rtreichl/RGB_Led_Controller/(list of files, drawings)

Other design files:
eagle/LED Sockel.pcb
