rtreichl/RGB_Led_Controller/eagle/LED Sockel.brd

## EAGLE design eagle/LED Sockel.brd (2016-02-29)

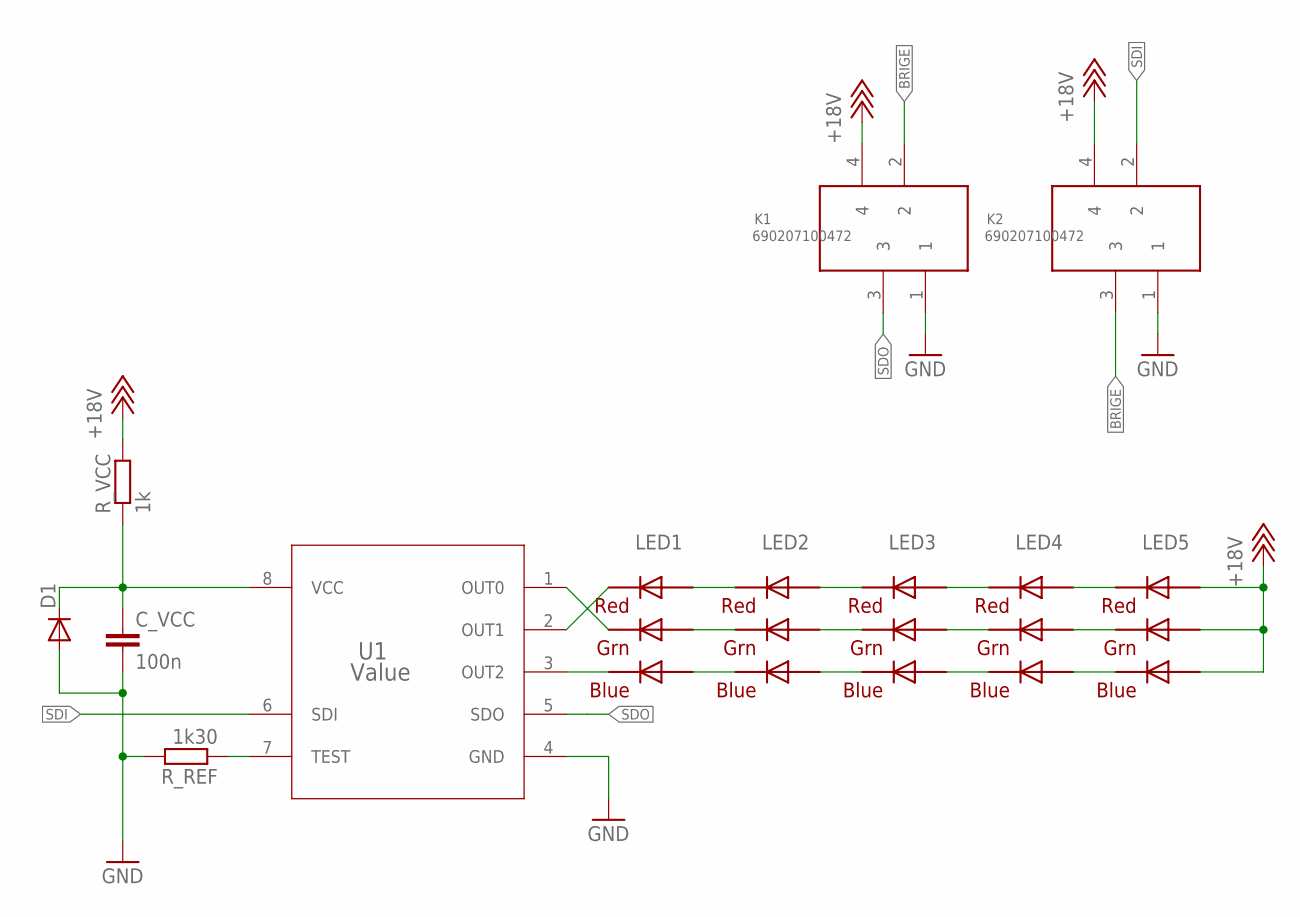
[picture p1: schematic LED Sockel.sch, LED]

Parts:
C_VCC: 100n; C0603
D1: DIODE-SOD523; SOD523
K1, K2: 690207100472
LED1, LED2, LED3, LED4, LED5: RGBLED5050
R_REF: 1k30; R0603
R_VCC: 1k; R0805
U1: Value; D0008A_N

Connections:
+18V: K1.4, K2.4, LED5.1 (GREEN_A), LED5.2 (RED_A), LED5.3 (BLUE_A), R_VCC.2
BRIGE: K1.2, K2.3
GND: C_VCC.2, D1.A, K1.1, K2.1, R_REF.2, U1.4 (GND)
unnamed: LED4.1 (GREEN_A), LED5.6 (GREEN_C)
unnamed: LED4.3 (BLUE_A), LED5.4 (BLUE_C)
unnamed: LED4.2 (RED_A), LED5.5 (RED_C)
unnamed: LED3.1 (GREEN_A), LED4.6 (GREEN_C)
unnamed: LED3.3 (BLUE_A), LED4.4 (BLUE_C)
unnamed: LED3.2 (RED_A), LED4.5 (RED_C)
unnamed: LED2.1 (GREEN_A), LED3.6 (GREEN_C)
unnamed: LED2.3 (BLUE_A), LED3.4 (BLUE_C)
unnamed: LED2.2 (RED_A), LED3.5 (RED_C)
unnamed: LED1.1 (GREEN_A), LED2.6 (GREEN_C)
unnamed: LED1.3 (BLUE_A), LED2.4 (BLUE_C)
unnamed: LED1.2 (RED_A), LED2.5 (RED_C)
unnamed: LED1.4 (BLUE_C), U1.3 (OUT2)
unnamed: LED1.6 (GREEN_C), U1.1 (OUT0)
unnamed: LED1.5 (RED_C), U1.2 (OUT1)
unnamed: C_VCC.1, D1.C, R_VCC.1, U1.8 (VCC)
unnamed: R_REF.1, U1.7 (TEST)
SDI: K2.2, U1.6 (SDI)
SDO: K1.3, U1.5 (SDO)

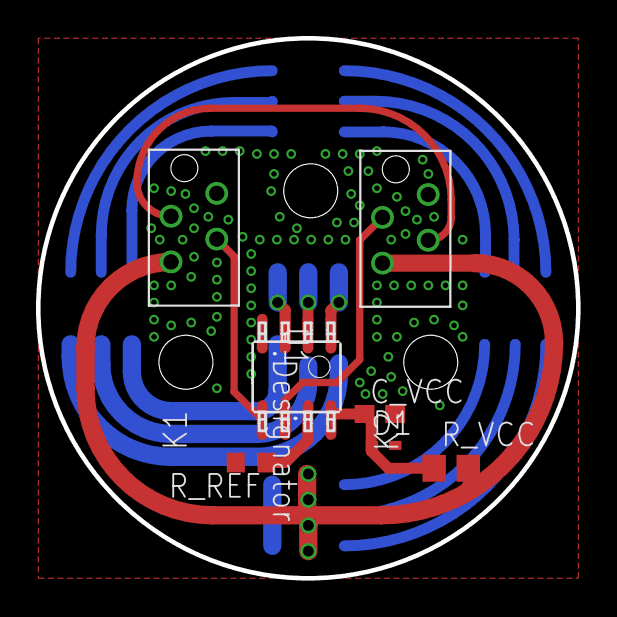
[picture p2: board LED Sockel.brd from above]

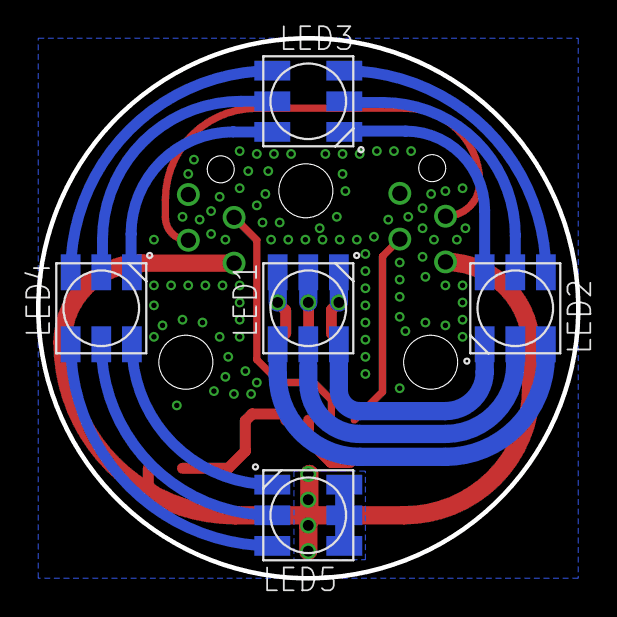
[picture p3: board LED Sockel.brd from below]

Board: 2 copper layers, 30.0 x 30.0 mm, 12 parts (5 on the bottom side), 22 nets.
