rtreichl/RGB_Led_Controller/eagle/LED Controller.brd

## EAGLE design eagle/LED Controller.brd (2016-02-29)

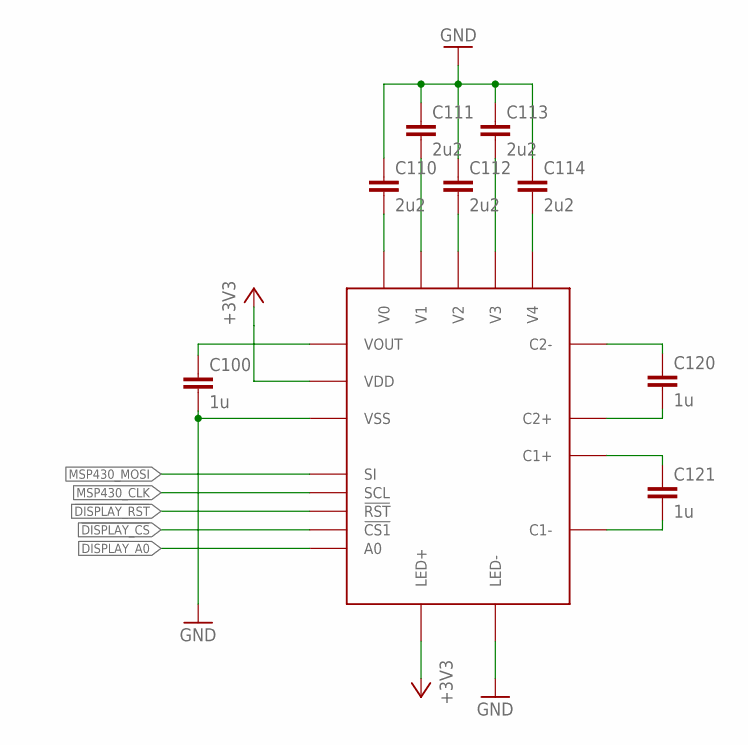
[picture p4: schematic LED Controller.sch, sheet 1, Display]

Parts:
C100, C120, C121: 1u; C0603
C110, C111, C112, C113, C114: 2u2; C0603
U$3: DISPLAY; NHD-C12832A1Z-NSW-BBW-3V3

Connections:
!DISPLAY_CS: U$3.P17 (!CS1); also elsewhere on the board
!DISPLAY_RST: U$3.P16 (!RST); also elsewhere on the board
+3V3: U$3.A (LED+), U$3.P12 (VDD); also elsewhere on the board
DISPLAY_A0: U$3.P15 (A0); also elsewhere on the board
GND: C100.2, C110.1, C111.1, C112.1, C113.1, C114.1, U$3.K (LED-), U$3.P11 (VSS); also elsewhere on the board
MSP430_CLK: U$3.P14 (SCL); also elsewhere on the board
MSP430_MOSI: U$3.P13 (SI); also elsewhere on the board
unnamed: C110.2, U$3.P1 (V0)
unnamed: C111.2, U$3.P2 (V1)
unnamed: C112.2, U$3.P3 (V2)
unnamed: C113.2, U$3.P4 (V3)
unnamed: C114.2, U$3.P5 (V4)
unnamed: C120.2, U$3.P7 (C2+)
unnamed: C120.1, U$3.P6 (C2-)
unnamed: C121.1, U$3.P8 (C1+)
unnamed: C121.2, U$3.P9 (C1-)
unnamed: C100.1, U$3.P10 (VOUT)

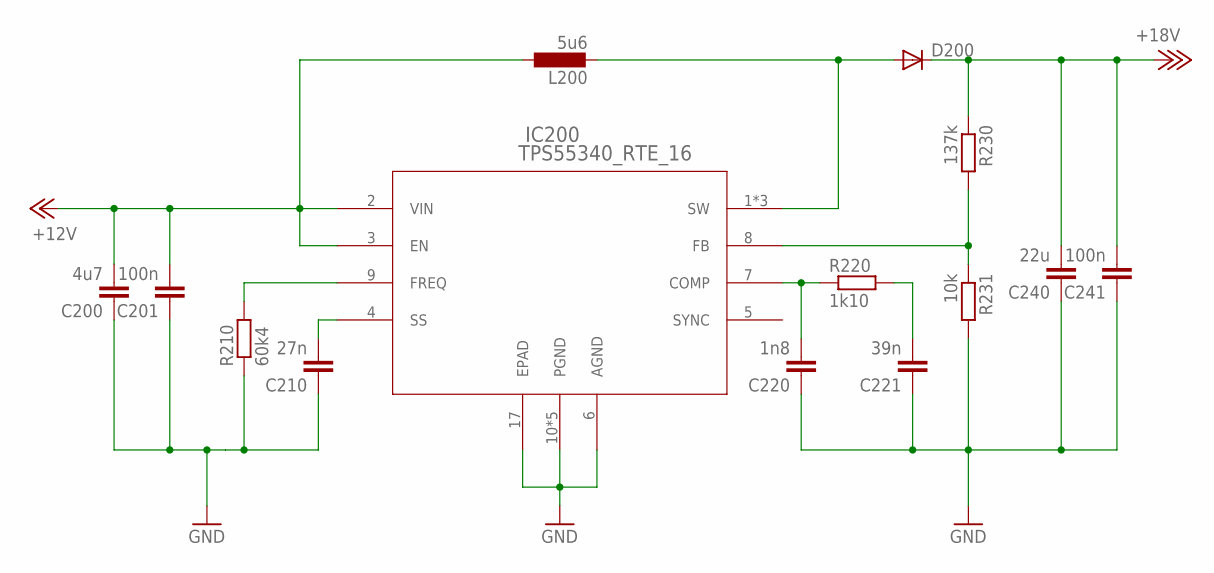
[picture p5: schematic LED Controller.sch, sheet 2, Boosted Converter]

Parts:
C200: 4u7; C1206
C201, C241: 100n; C1206
C210: 27n; C0603
C220: 1n8; C0603
C221: 39n; C0603
C240: 22u; C1210
D200: DIODE-SMC; SMC
IC200: TPS55340_RTE_16; RTE16
L200: 5u6; SRP5030T
R210: 60k4; R0603
R220: 1k10; R0603
R230: 137k; R0603
R231: 10k; R0603

Connections:
+12V: C200.2, C201.2, IC200.2 (VIN), IC200.3 (EN), L200.V_1 (1); also elsewhere on the board
+18V: C240.2, C241.2, D200.C, R230.1; also elsewhere on the board
GND: C200.1, C201.1, C210.1, C220.1, C221.1, C240.1, C241.1, IC200.6 (AGND), IC200.10 (PGND), IC200.11 (PGND), IC200.12 (PGND), IC200.13 (PGND), IC200.14 (PGND), IC200.17 (EPAD), R210.1, R231.2; also elsewhere on the board
unnamed: C220.2, IC200.7 (COMP), R220.1
unnamed: D200.A, IC200.1 (SW), IC200.15 (SW), IC200.16 (SW), L200.V_2 (2)
unnamed: IC200.8 (FB), R230.2, R231.1
unnamed: IC200.9 (FREQ), R210.2
unnamed: C210.2, IC200.4 (SS)
unnamed: C221.2, R220.2

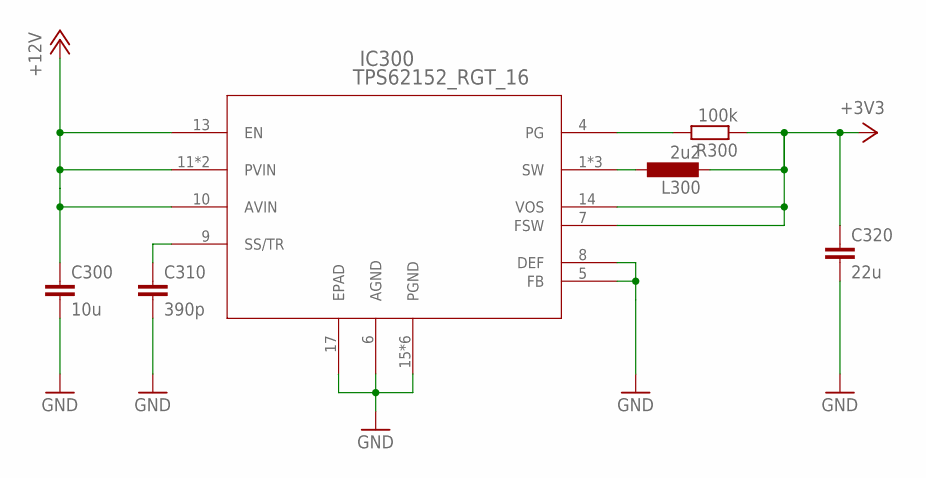
[picture p6: schematic LED Controller.sch, sheet 3, Bucked Converter]

Parts:
C300: 10u; C0805
C310: 390p; C0603
C320: 22u; C0805
IC300: TPS62152_RGT_16; RGT16_1P7X1P7
L300: 2u2; SDR0403
R300: 100k; R0603

Connections:
+3V3: C320.1, IC300.7 (FSW), IC300.14 (VOS), L300.V_2 (2), R300.1; also elsewhere on the board
+12V: C300.1, IC300.10 (AVIN), IC300.11 (PVIN), IC300.12 (PVIN), IC300.13 (EN); also elsewhere on the board
GND: C300.2, C310.2, C320.2, IC300.5 (FB), IC300.6 (AGND), IC300.8 (DEF), IC300.15 (PGND), IC300.16 (PGND), IC300.17 (EPAD), IC300.V (PGND), IC300.V_1 (PGND), IC300.V_2 (PGND), IC300.V_3 (PGND); also elsewhere on the board
unnamed: IC300.1 (SW), IC300.2 (SW), IC300.3 (SW), L300.V_1 (1)
unnamed: IC300.4 (PG), R300.2
unnamed: C310.1, IC300.9 (SS/TR)

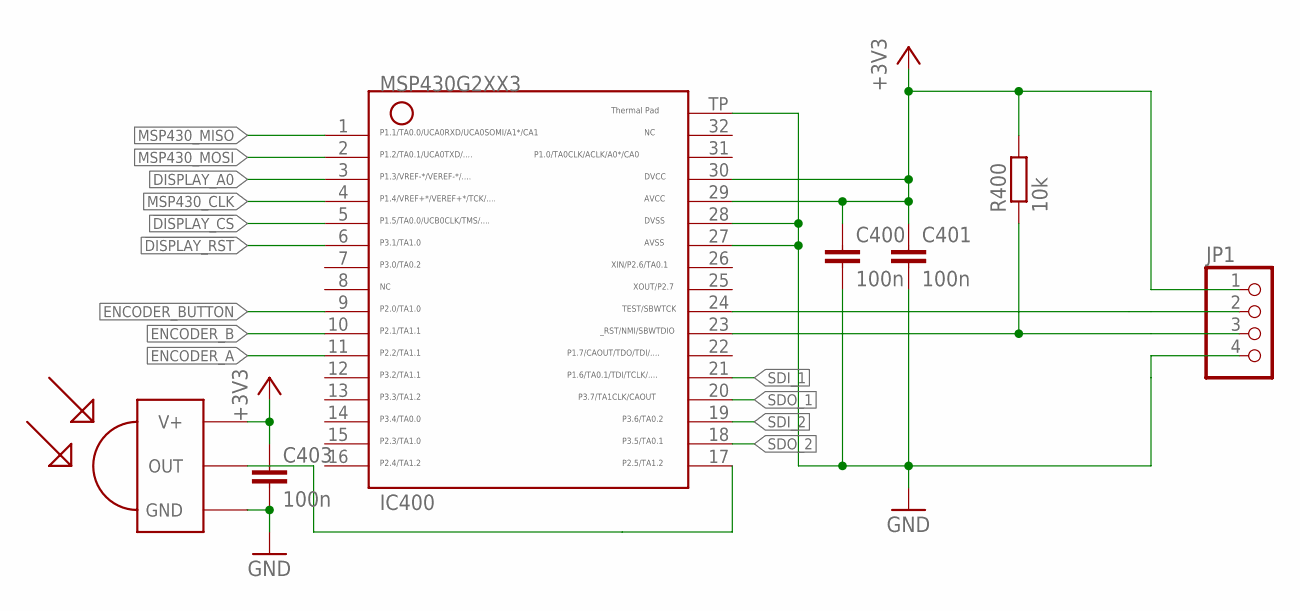
[picture p7: schematic LED Controller.sch, sheet 4, Mikorcontroller]

Parts:
C400, C401, C403: 100n; C0603
IC400: G2XX3---RHB32; RHB32
JP1: PINHD-1X4; 1X04
R400: 10k; R0603
U$1: TSOP1738; TSOP17XX

Connections:
!DISPLAY_CS: IC400.5; also elsewhere on the board
!DISPLAY_RST: IC400.6; also elsewhere on the board
+3V3: C400.1, C401.1, C403.1, IC400.29, IC400.30, JP1.1, R400.2, U$1.V+; also elsewhere on the board
DISPLAY_A0: IC400.3; also elsewhere on the board
ENCODER_A: IC400.11; also elsewhere on the board
ENCODER_B: IC400.10; also elsewhere on the board
ENCODER_BUTTON: IC400.9; also elsewhere on the board
GND: C400.2, C401.2, C403.2, IC400.27, IC400.28, IC400.TP, JP1.4, U$1.GND; also elsewhere on the board
MSP430_CLK: IC400.4; also elsewhere on the board
MSP430_MISO: IC400.1
MSP430_MOSI: IC400.2; also elsewhere on the board
unnamed: IC400.24, JP1.2
unnamed: IC400.23, JP1.3, R400.1
unnamed: IC400.17, U$1.OUT
SDI_1: IC400.21; also elsewhere on the board
SDI_2: IC400.19; also elsewhere on the board
SDO_1: IC400.20; also elsewhere on the board
SDO_2: IC400.18; also elsewhere on the board

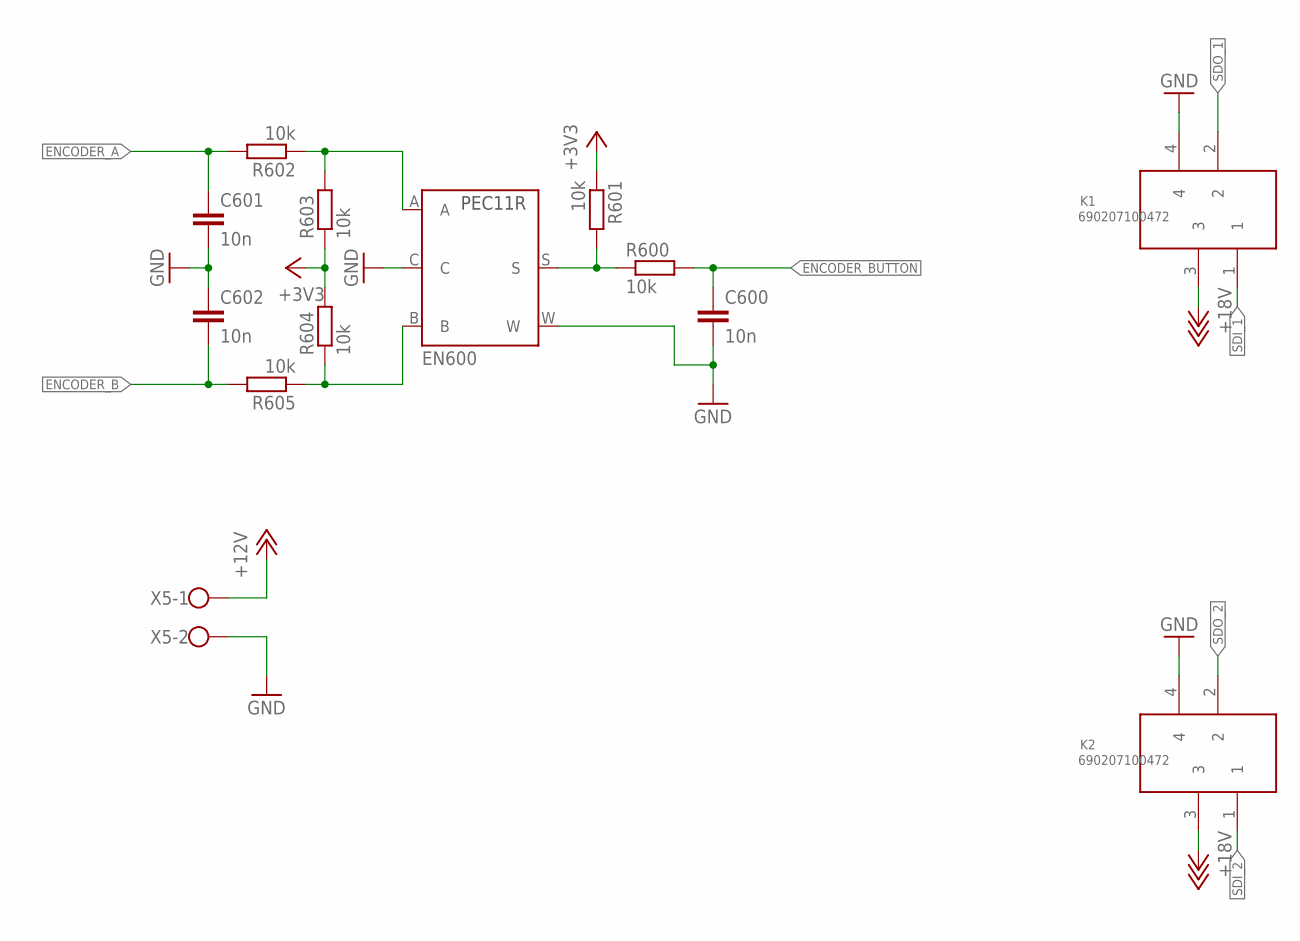
[picture p8: schematic LED Controller.sch, sheet 5, Encoder Connectors]

Parts:
C600, C601, C602: 10n; C0603
EN600: PEC11R
K1, K2: 690207100472
R600, R601, R602, R603, R604, R605: 10k; R0603
X5: W237-102

Connections:
+3V3: R601.1, R603.1, R604.2; also elsewhere on the board
+12V: X5.1; also elsewhere on the board
+18V: K1.3, K2.3; also elsewhere on the board
ENCODER_A: C601.1, R602.2; also elsewhere on the board
ENCODER_B: C602.2, R605.2; also elsewhere on the board
ENCODER_BUTTON: C600.1, R600.2; also elsewhere on the board
GND: C600.2, C601.2, C602.1, EN600.C, EN600.W, K1.4, K2.4, X5.2; also elsewhere on the board
unnamed: EN600.A, R602.1, R603.2
unnamed: EN600.B, R604.1, R605.1
unnamed: EN600.S, R600.1, R601.2
SDI_1: K1.1; also elsewhere on the board
SDI_2: K2.1; also elsewhere on the board
SDO_1: K1.2; also elsewhere on the board
SDO_2: K2.2; also elsewhere on the board

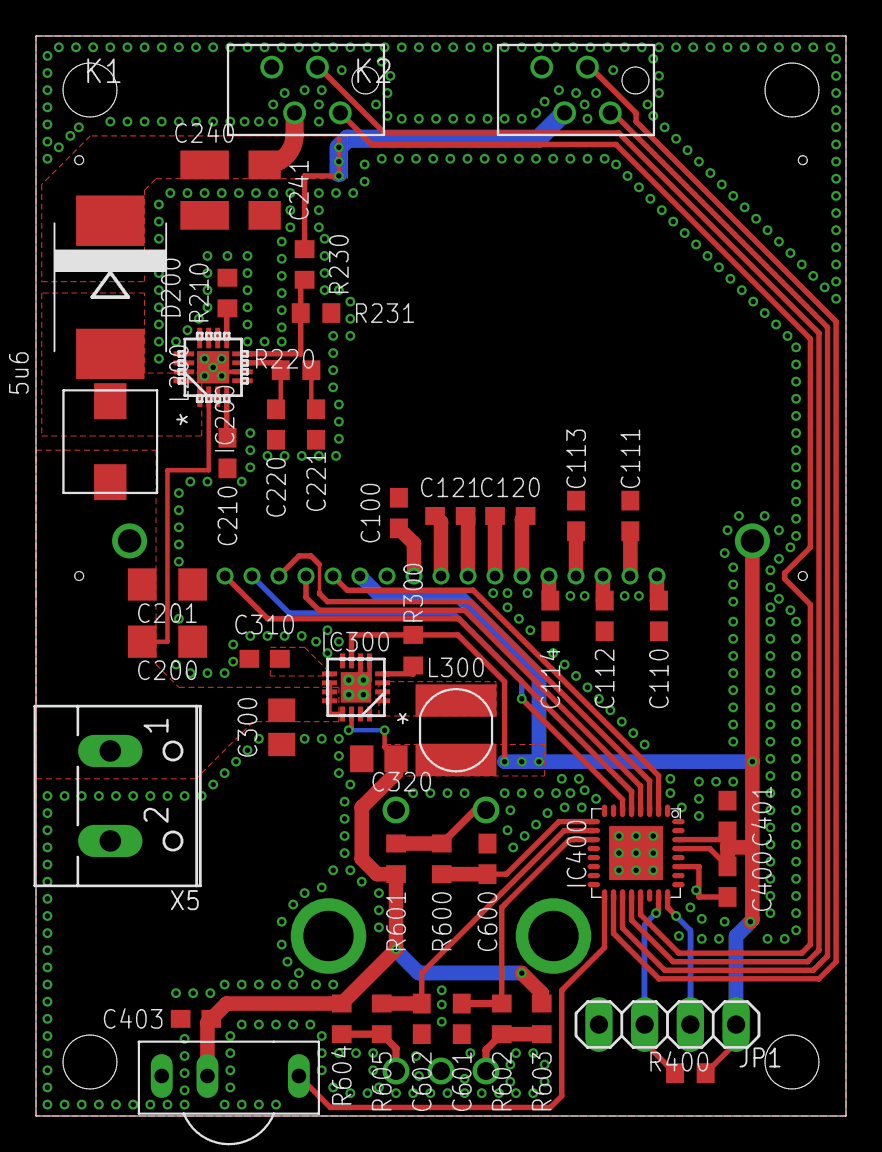
[picture p9: board LED Controller.brd from above]

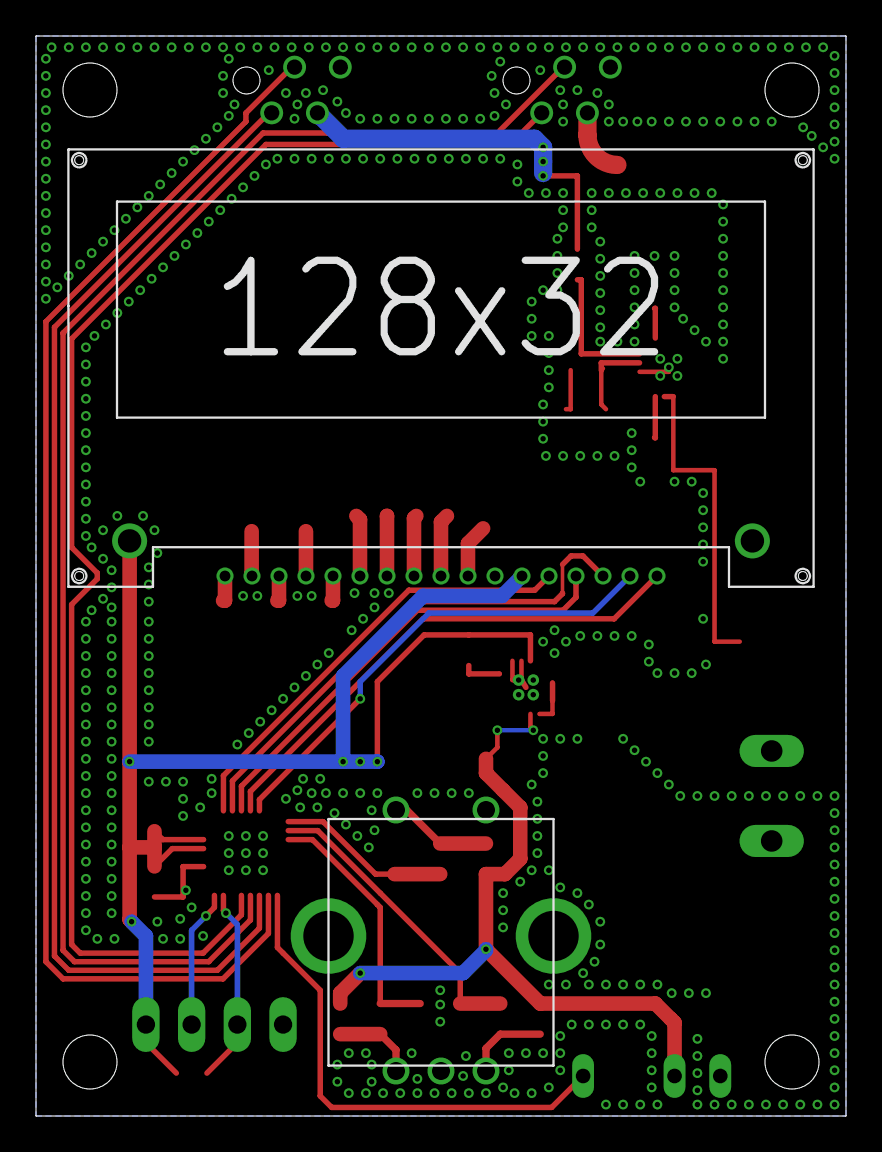
[picture p10: board LED Controller.brd from below]

Board: 2 copper layers, 45.0 x 60.0 mm, 49 parts (2 on the bottom side), 41 nets.
