rtreichl/RGB_Led_Controller/(notices)

Notices in the files:
parts and their libraries:
Wurth_Elektronik_Electromechanic_Wire_to: Copyright: Würth Elektronik
